TheCacophonyProject/spool-pcb/README.md

# Spool PCB

## Other bits to order

### DigiKey

- 2 x Crimped leads: [455-4118-ND](https://www.digikey.com/en/products/detail/jst-sales-america-inc/ASXASXA22K254/9951627) Can chop in half and use 2 of the ends for the motor and 2 for the magnet
- 1 x 8 Pin cable assembly [455-3842-ND](https://www.digikey.com/en/products/detail/jst-sales-america-inc/A08XAF08XAF22K203B/9922118) for connecting main and plug board.
- 3 x Protection Diodes [SS54-HF](https://www.digikey.com/en/products/detail/comchip-technology/SS54-HF/11584321) to be hand soldered onto the plug board.

### LCSC

- 2 x Photo interrupter [DY-ITR8402](https://www.lcsc.com/product-detail/C390039.html)
- 1 x 2 Pin JST XA housing [XAP-02V-1](https://www.lcsc.com/product-detail/C157892.html)
- 1 x 3 Pin JST XA housing [XAP-03V-1](https://www.lcsc.com/product-detail/C157891.html)
- 2 x 8 Pin JST XA Plug [S08B-XASK-1(LF)(SN)](https://www.lcsc.com/product-detail/C495695.html)
- 1 x Magnet rotary position sensor? Not too sure if this will end up being used or not. [AS5600-ASOT](https://www.lcsc.com/product-detail/C499458.html)

### JNICON

- 1 x 6 Pin Auxiliary plug (TODO: Add part number)
- 1 x 4 Pin Power plug (TODO: Add part number)

## Construction

TODO: Write construction/programming instructions.
