TheCacophonyProject/spool-pcb/spool-plugs/solder-helper.FCStd

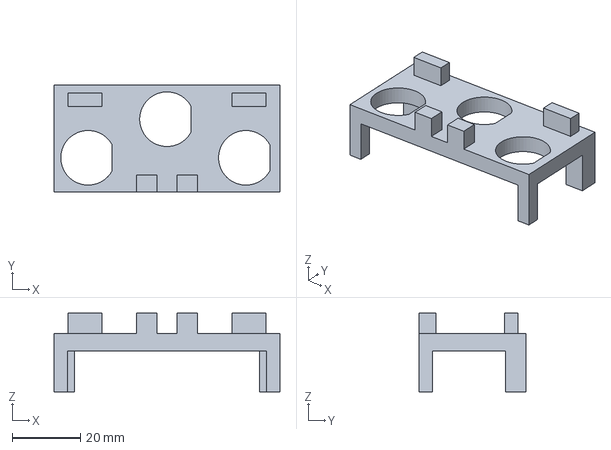
[picture p1: CAD file, 2026-06-03]
spool-plugs/solder-helper.FCStd
66.2 x 31.3 x 23.0 mm
