TheCacophonyProject/spool-pcb/(list of files, cad)

Other CAD files:
cage-hub/drawings/cage-hub.FCStd
spool-plugs/drawings/spool-plugs-drawings.FCStd
spool/drawings/spool.FCStd
spool/drawings/cutout.FCStd
