TheCacophonyProject/spool-pcb/spool/spool.kicad_pcb

## KiCad design spool/spool.kicad_pcb (2026-11-05)

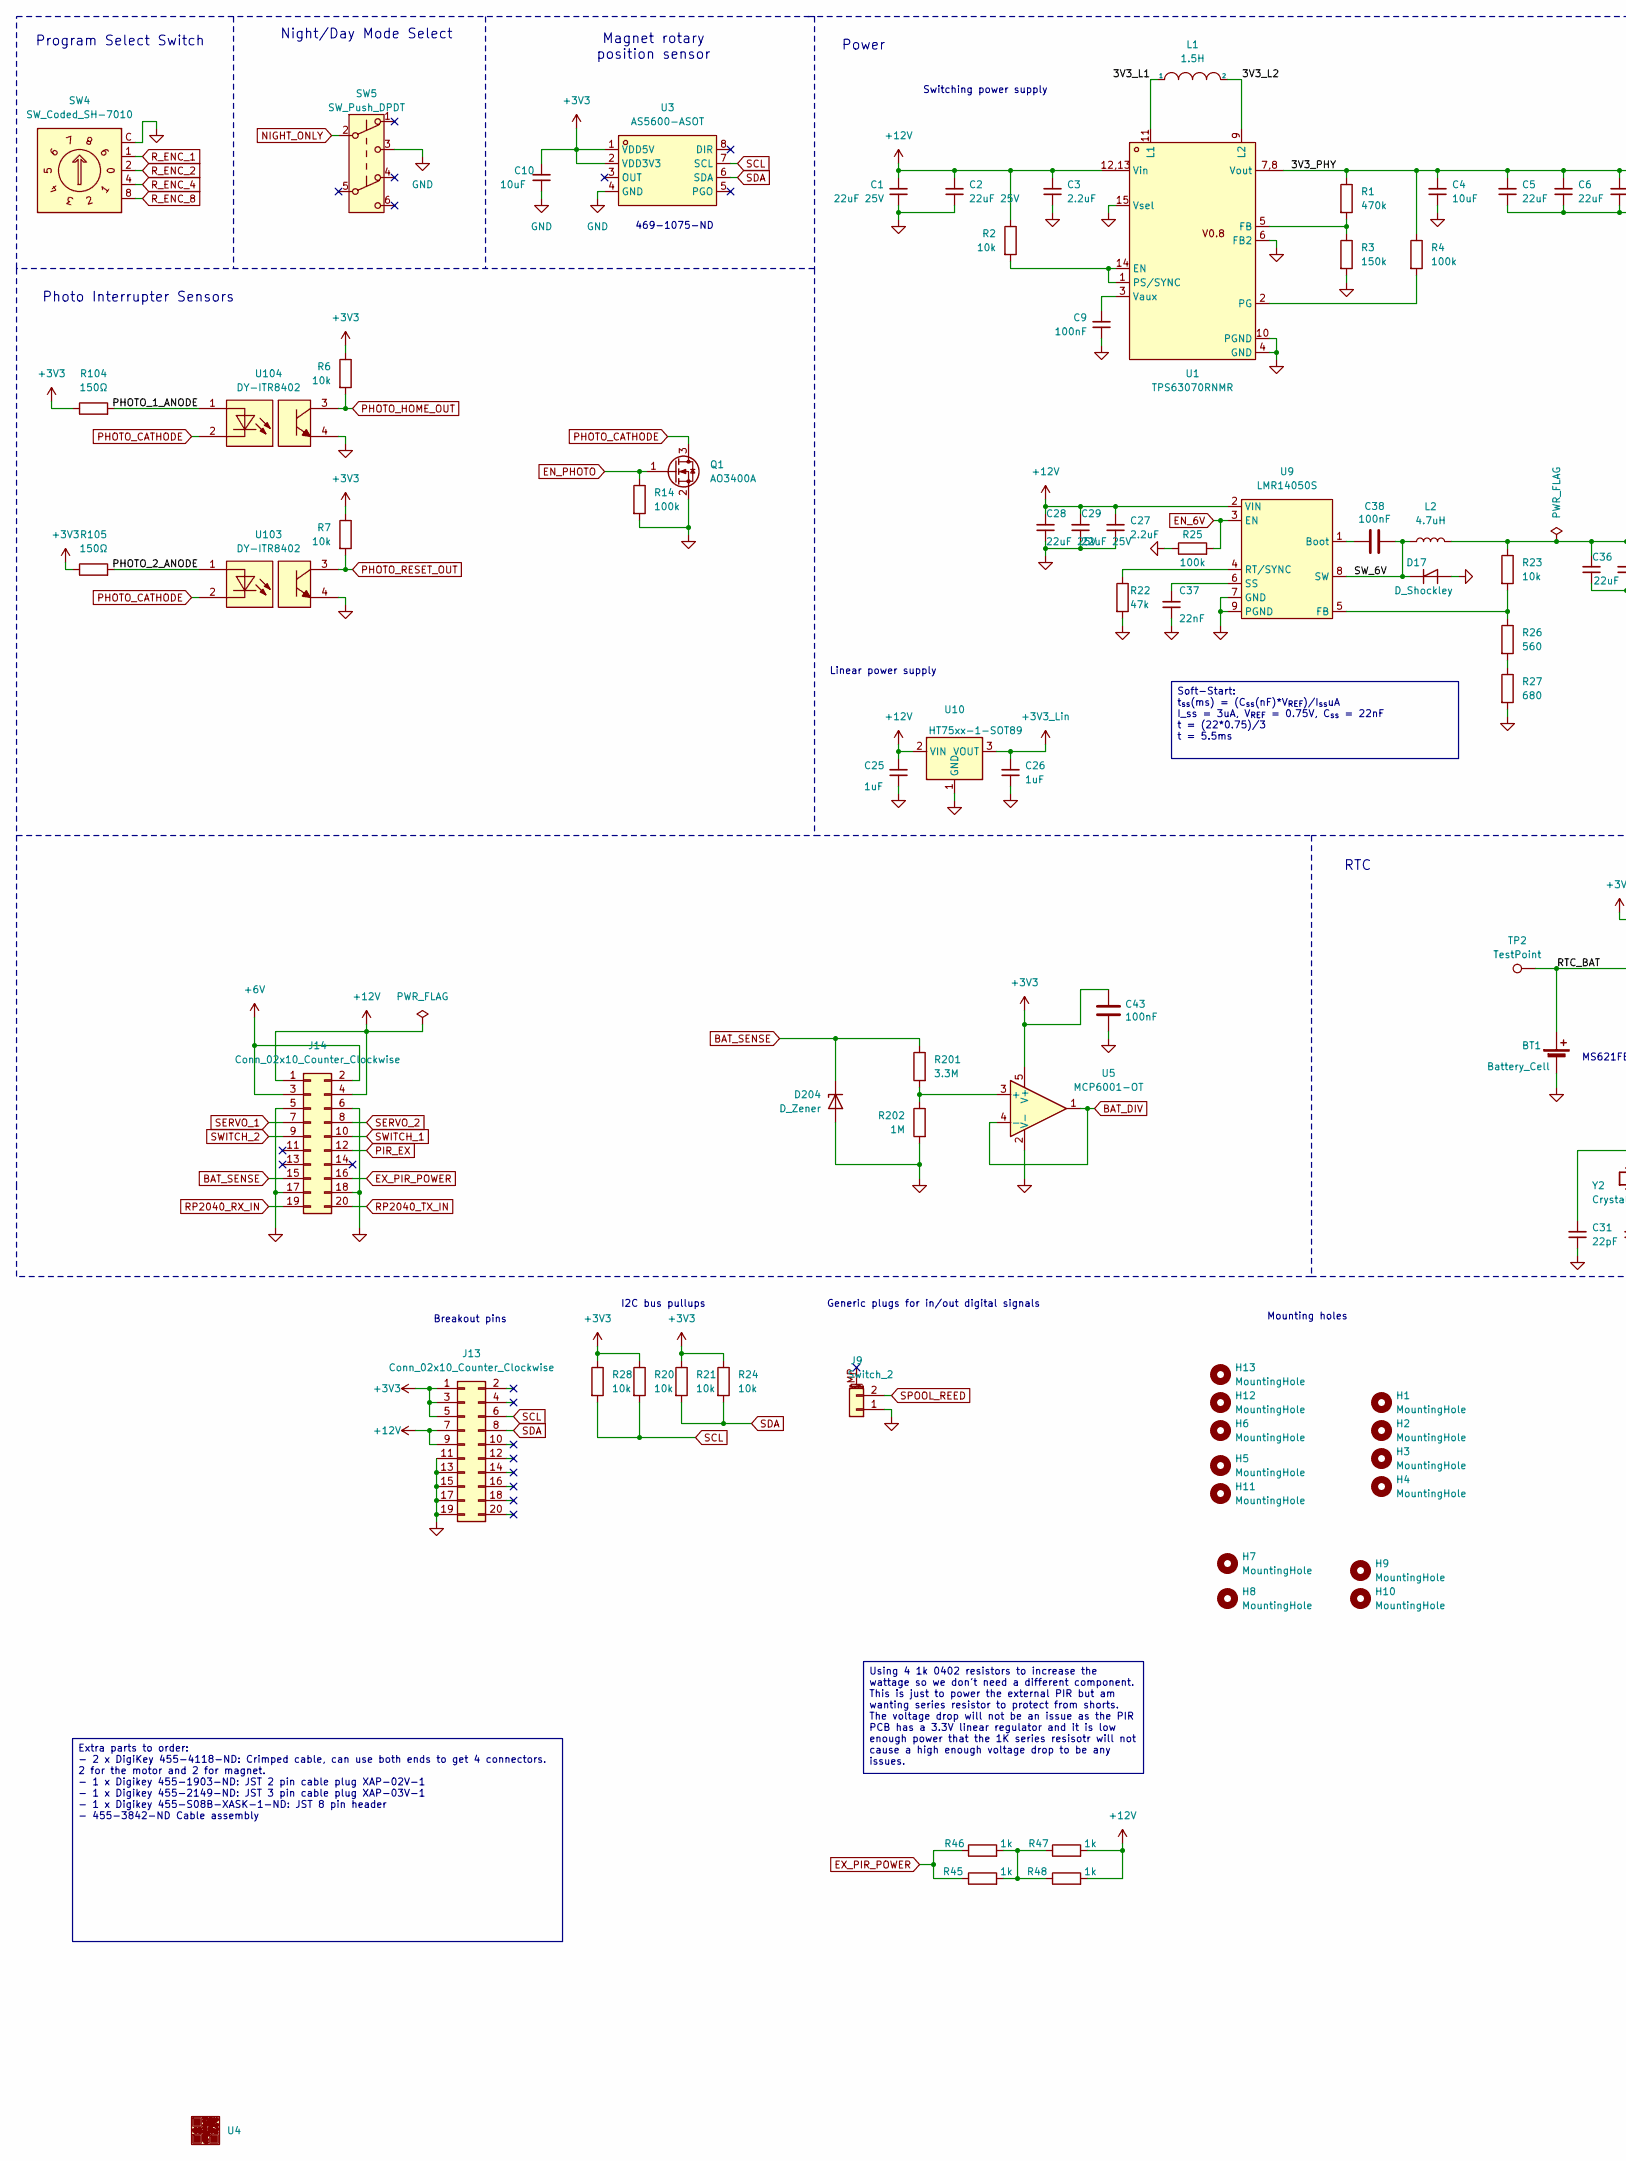
[picture p2: schematic spool.kicad_sch, part in row 1, column 1]

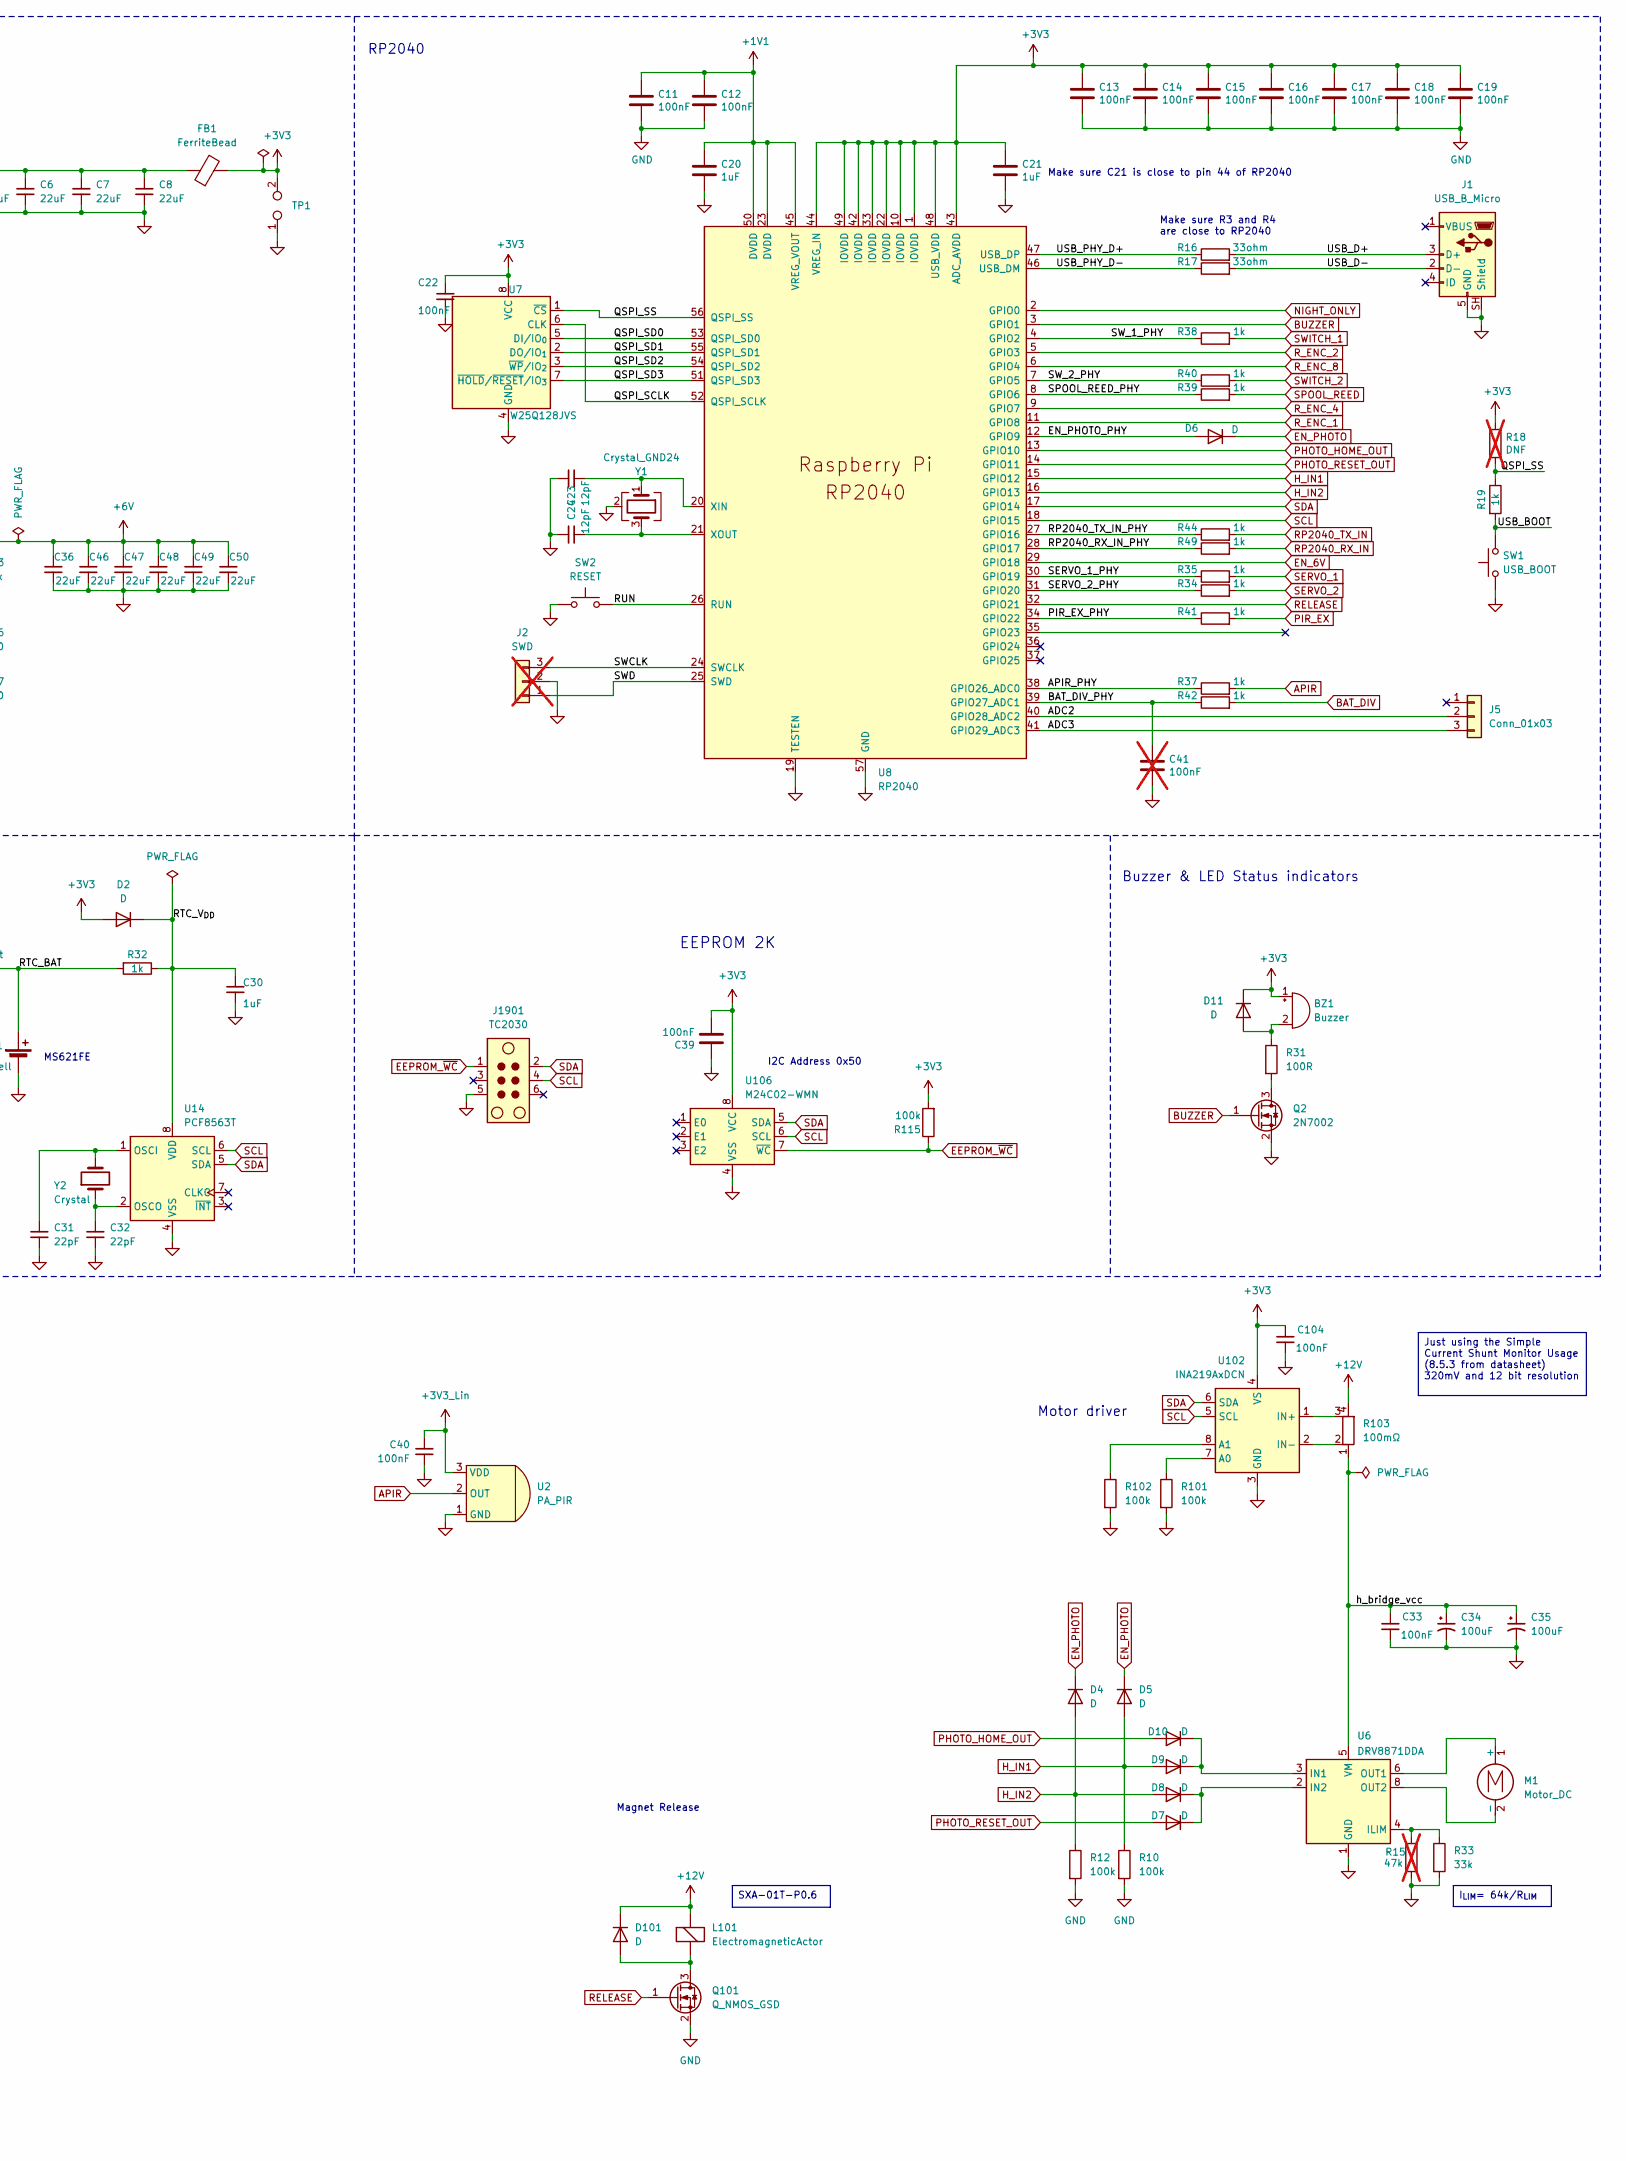
[picture p3: schematic spool.kicad_sch, part in row 1, column 2]

Parts:
BT1: Battery_Cell; CAP-SMD_FL11E; LCSC Part C80909
BZ1: Buzzer; BUZ-TH_BD9.0-P4.00-D0.6-FD; LCSC Part C96256
C1, C2, C28, C29: 22uF 25V; C_0805_2012Metric; LCSC Part C45783
C3, C27: 2.2uF; C_0402_1005Metric; LCSC Part C159814
C4, C10: 10uF; C_0402_1005Metric; LCSC Part C15525
C5, C6, C7, C8, C36, C46, C47, C48, C49, C50: 22uF; C_0603_1608Metric; LCSC Part C86295
C9, C11, C12, C13, C14, C15, C16, C17, C18, C19, C22, C33, C38, C39, C40, C43, C104: 100nF; C_0402_1005Metric; LCSC Part C307331
C20, C21, C25, C26, C30: 1uF; C_0402_1005Metric; LCSC Part C52923
C23, C24: 12pF; C_0402_1005Metric; LCSC Part C1547
C31, C32: 22pF; C_0402_1005Metric; LCSC Part C1555
C34, C35: 100uF; CP_Elec_6.3x7.7; LCSC Part C3338
C37: 22nF; C_0402_1005Metric; LCSC Part C1532
C41: 100nF; C_0402_1005Metric; LCSC Part C307331; not fitted
D2, D4, D5, D6, D7, D8, D9, D10, D11, D101: D; D_SOD-323; LCSC Part C2128
D17: D_Shockley; D_SMA; LCSC Part C22452
D204: D_Zener; D_SOD-123; LCSC Part C19077413
FB1: FerriteBead; L_0805_2012Metric; LCSC Part C76818
H1, H2, H3, H4, H9, H10: MountingHole; MountingHole_3.5mm_M3
H5, H6, H7, H8, H11, H12, H13: MountingHole; 3.0mm_key_hole
J1: USB_B_Micro; MICRO-USB-TH_MICRO-USB-A14; LCSC Part C145795
J2: SWD; PinHeader_1x03_P1.00mm_Vertical; not fitted
J5: Conn_01x03; PinHeader_1x03_P2.54mm_Vertical
J9: Switch_2; JST_SH_BM02B-SRSS-TB_1x02-1MP_P1.00mm_Vertical; LCSC Part C160388
J13: Conn_02x10_Counter_Clockwise; test-headers
J14: Conn_02x10_Counter_Clockwise; PinSocket_2x10_P2.54mm_Vertical; LCSC Part C92266
J1901: TC2030; Tag-Connect_TC2030-IDC-NL_2x03_P1.27mm_Vertical
L1: 1.5H; L_1008_2520Metric; LCSC Part C2042459
L2: 4.7uH; IND-SMD_L7.0-W6.6; LCSC Part C408447
L101: ElectromagneticActor; JST_XA_B03B_2_Pin; LCSC Part C264992
M1: Motor_DC; JST_XA_B02B-XASK-1-A_1x02_P2.50mm_Vertical; LCSC Part C265077
Q1: AO3400A; SOT-23; LCSC Part C20917
Q2: 2N7002; SOT-23; LCSC Part C8545
Q101: Q_NMOS_GSD; SOT-23; LCSC Part C332302
R1: 470k; R_0402_1005Metric; LCSC Part C319591
R2, R6, R7, R20, R21, R23, R24, R28: 10k; R_0402_1005Metric; LCSC Part C25744
R3: 150k; R_0402_1005Metric; LCSC Part C723770
R4, R10, R12, R14, R25, R101, R102, R115: 100k; R_0402_1005Metric; LCSC Part C25741
R15: 47k; R_Axial_DIN0204_L3.6mm_D1.6mm_P7.62mm_Horizontal; not fitted
R16, R17: 33ohm; R_0402_1005Metric; LCSC Part C25105
R18: DNF; R_0402_1005Metric; not fitted
R19, R32, R34, R35, R37, R38, R39, R40, R41, R42, R44, R45, R46, R47, R48, R49: 1k; R_0402_1005Metric; LCSC Part C11702
R22: 47k; R_0402_1005Metric; LCSC Part C25792
R26: 560; R_0603_1608Metric; LCSC Part C23204
R27: 680; R_0603_1608Metric; LCSC Part C23228
R31: 100R; R_0402_1005Metric; LCSC Part C25076
R33: 33k; R_0805_2012Metric_Pad1.20x1.40mm_HandSolder; LCSC Part C17633
R103: 100mΩ; R_1206_Shunt; LCSC Part C25334
R104, R105: 150Ω; R_0603_1608Metric; LCSC Part C22808
R201: 3.3M; R_0603_1608Metric; LCSC Part C26096
R202: 1M; R_0603_1608Metric; LCSC Part C22935
SW1: USB_BOOT; SW_SPST_SKQG_WithStem; LCSC Part C318884
SW2: RESET; SW_SPST_SKQG_WithStem; LCSC Part C318884
SW4: SW_Coded_SH-7010; SW-TH_6P-L10.0-W10.0-P2.54-LS7.6_TSR-10; LCSC Part C440495
SW5: SW_Push_DPDT; SW-TH_K3-2235D-F1; LCSC Part C189615
TP1: TestPoint_2Pole; test-point-2p
TP2: TestPoint; TestPoint_Loop_D1.80mm_Drill1.0mm_Beaded
U1: TPS63070RNMR; TPS63070; LCSC Part C109322
U2: PA_PIR
U3: AS5600-ASOT; SOIC-8_3.9x4.9mm_P1.27mm; LCSC Part C499458
U4: JLCPCB_QR_8mm
U5: MCP6001-OT; SOT-23-5; LCSC Part C29429
U6: DRV8871DDA; Texas_HTSOP-8-1EP_3.9x4.9mm_P1.27mm_EP2.95x4.9mm_Mask2.4x3.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; LCSC Part C75864
U7: W25Q128JVS; SOIC-8_5.3x5.3mm_P1.27mm; LCSC Part C97521
U8: RP2040; RP2040-QFN-56; LCSC Part C2040
U9: LMR14050S; TI_SO-PowerPAD-8; LCSC Part C155484
U10: HT75xx-1-SOT89; SOT-89-3; LCSC Part C14289
U14: PCF8563T; SOIC-8_3.9x4.9mm_P1.27mm; LCSC Part C7440
U102: INA219AxDCN; SOT-23-8; LCSC Part C87469
U103, U104: DY-ITR8402; OPTO-TH_DY-ITR8402; LCSC Part C390039
U106: M24C02-WMN; SOIC-8_3.9x4.9mm_P1.27mm; LCSC Part C7562
Y1: Crystal_GND24; Crystal_SMD_3225-4Pin_3.2x2.5mm; LCSC Part C9002
Y2: Crystal; Crystal_SMD_3215-2Pin_3.2x1.5mm; LCSC Part C32346

Connections:
+1V1: C11.1, C12.1, C20.1, U8.23 (DVDD), U8.45 (VREG_VOUT), U8.50 (DVDD)
+3V3: BZ1.1 (+), C10.1, C13.1, C14.1, C15.1, C16.1, C17.1, C18.1, C19.1, C21.1, C22.1, C39.2, C43.1, C104.1, D2.2 (A), D11.1 (K), FB1.2, J13.1, J13.3, J13.5, R6.1, R7.1, R18.1, R20.1, R21.1, R24.1, R28.1, R104.1, R105.1, R115.2, TP1.2, U3.1 (VDD5V), U3.2 (VDD3V3), U5.5 (V+), U7.8 (VCC), U8.1 (IOVDD), U8.10 (IOVDD), U8.22 (IOVDD), U8.33 (IOVDD), U8.42 (IOVDD), U8.43 (ADC_AVDD), U8.44 (VREG_IN), U8.48 (USB_VDD), U8.49 (IOVDD), U102.4 (VS), U106.8 (VCC)
+3V3_Lin: C26.1, C40.1, U2.3 (VDD), U10.3 (VOUT)
+6V: C36.1, C46.1, C47.1, C48.1, C49.1, C50.1, J14.2, J14.3, L2.2, R23.1
+12V: C1.1, C2.1, C3.1, C25.1, C27.1, C28.1, C29.1, D101.1 (K), J13.7, J13.9, J14.1, J14.4, L101.1 (-), R2.1, R47.2, R48.2, R103.4, U1.12,13 (Vin), U9.2 (VIN), U10.2 (VIN)
/3V3_L1: L1.1, U1.11 (L1)
/3V3_L2: L1.2, U1.9 (L2)
/3V3_PHY: C4.1, C5.1, C6.1, C7.1, C8.1, FB1.1, R1.1, R4.1, U1.7,8 (Vout)
/ADC2: J5.2, U8.40 (GPIO28_ADC2)
/ADC3: J5.3, U8.41 (GPIO29_ADC3)
/APIR_PHY: R37.1, U8.38 (GPIO26_ADC0)
/BAT_DIV_PHY: C41.1, R42.1, U8.39 (GPIO27_ADC1)
/EN_PHOTO_PHY: D6.2 (A), U8.12 (GPIO9)
/PHOTO_1_ANODE: R104.2, U104.1
/PHOTO_2_ANODE: R105.2, U103.1
/PIR_EX_PHY: R41.1, U8.34 (GPIO22)
/QSPI_SCLK: U7.6 (CLK), U8.52 (QSPI_SCLK)
/QSPI_SD0: U7.5 (DI/IO_{0}), U8.53 (QSPI_SD0)
/QSPI_SD1: U7.2 (DO/IO_{1}), U8.55 (QSPI_SD1)
/QSPI_SD2: U7.3 (~WP/IO_{2}), U8.54 (QSPI_SD2)
/QSPI_SD3: U7.7 (~HOLD/~RESET/IO_{3}), U8.51 (QSPI_SD3)
/QSPI_SS: R18.2, R19.1, U7.1 (~CS), U8.56 (QSPI_SS)
/RP2040_RX_IN_PHY: R49.1, U8.28 (GPIO17)
/RP2040_TX_IN_PHY: R44.1, U8.27 (GPIO16)
/RTC_BAT: BT1.1 (+), R32.2, TP2.1 (1_1)
/RTC_V_{DD}: C30.1, D2.1 (K), R32.1, U14.8 (VDD)
/RUN: SW2.2, U8.26 (RUN)
/SERVO_1_PHY: R35.1, U8.30 (GPIO19)
/SERVO_2_PHY: R34.1, U8.31 (GPIO20)
/SPOOL_REED_PHY: R39.1, U8.8 (GPIO6)
/SWCLK: J2.3, U8.24 (SWCLK)
/SWD: J2.1, U8.25 (SWD)
/SW_1_PHY: R38.1, U8.4 (GPIO2)
/SW_2_PHY: R40.1, U8.7 (GPIO5)
/SW_6V: C38.1, D17.1 (K), L2.1, U9.8 (SW)
/USB_BOOT: R19.2, SW1.2
/USB_D+: J1.3 (D+), R16.2
/USB_D-: J1.2 (D-), R17.2
/USB_PHY_D+: R16.1, U8.47 (USB_DP)
/USB_PHY_D-: R17.1, U8.46 (USB_DM)
/h_bridge_vcc: C33.1, C34.1, C35.1, R103.1, U6.5 (VM)
APIR: R37.2, U2.2 (OUT)
BAT_DIV: R42.2, U5.1, U5.4 (-)
BAT_SENSE: D204.1 (K), J14.15, R201.1
BUZZER: Q2.1 (G), U8.3 (GPIO1)
EEPROM_~WC: J1901.1, R115.1, U106.7 (~WC)
EN_6V: R25.2, U8.29 (GPIO18), U9.3 (EN)
EN_PHOTO: D4.1 (K), D5.1 (K), D6.1 (K), Q1.1 (G), R14.1
EX_PIR_POWER: J14.16, R45.1, R46.1
GND: BT1.2 (-), C1.2, C2.2, C3.2, C4.2, C5.2, C6.2, C7.2, C8.2, C9.2, C10.2, C11.2, C12.2, C13.2, C14.2, C15.2, C16.2, C17.2, C18.2, C19.2, C20.2, C21.2, C22.2, C23.1, C24.1, C25.2, C26.2, C27.2, C28.2, C29.2, C30.2, C31.2, C32.2, C33.2, C34.2, C35.2, C36.2, C37.2, C39.1, C40.2, C41.2, C43.2, C46.2, C47.2, C48.2, C49.2, C50.2, C104.2, D17.2 (A), D204.2 (A), J1.5 (GND), J1.SH (Shield), J2.2, J9.1, J13.11, J13.13, J13.15, J13.17, J13.19, J14.5, J14.6, J14.17, J14.18, J1901.5, Q1.2 (S), Q2.2 (S), Q101.2 (S), R3.2, R10.2, R12.2, R14.2, R15.2, R22.2, R25.1, R27.2, R33.2, R101.2, R102.2, R202.2, SW1.1, SW2.1, SW4.C, SW5.3 (C), TP1.1, U1.4 (GND), U1.6 (FB2), U1.10 (PGND), U1.15 (Vsel), U2.1 (GND), U3.4 (GND), U5.2 (V-), U6.1 (GND), U6.7 (GND), U6.9 (GND), U7.4 (GND), U8.19 (TESTEN), U8.57 (GND), U9.7 (GND), U9.9 (PGND), U10.1 (GND), U14.4 (VSS), U102.3 (GND), U103.4, U104.4, U106.4 (VSS), Y1.2 (G), Y1.4 (G)
H_IN1: D5.2 (A), D9.2 (A), R10.1, U8.15 (GPIO12)
H_IN2: D4.2 (A), D8.2 (A), R12.1, U8.16 (GPIO13)
NIGHT_ONLY: SW5.2 (B), U8.2 (GPIO0)
unnamed: BZ1.2 (-), D11.2 (A), R31.1
unnamed: D7.1 (K), D8.1 (K), U6.2 (IN2)
unnamed: D9.1 (K), D10.1 (K), U6.3 (IN1)
unnamed: D101.2 (A), L101.2 (+), Q101.3 (D)
unnamed: M1.1 (+), U6.6 (OUT1)
unnamed: M1.2 (-), U6.8 (OUT2)
unnamed: Q2.3 (D), R31.2
unnamed: R26.2, R27.1
unnamed: R45.2, R46.2, R47.1, R48.1
unnamed: R2.2, U1.1 (PS/SYNC), U1.14 (EN)
unnamed: R1.2, R3.1, U1.5 (FB)
unnamed: R4.2, U1.2 (PG)
unnamed: C9.1, U1.3 (Vaux)
unnamed: R201.2, R202.1, U5.3 (+)
unnamed: R15.1, R33.1, U6.4 (ILIM)
unnamed: C23.2, U8.20 (XIN), Y1.1
unnamed: C24.2, U8.21 (XOUT), Y1.3
unnamed: C38.2, U9.1 (Boot)
unnamed: R23.2, R26.1, U9.5 (FB)
unnamed: R22.1, U9.4 (RT/SYNC)
unnamed: C37.1, U9.6 (SS)
unnamed: C31.1, U14.1 (OSCI), Y2.2
unnamed: C32.1, U14.2 (OSCO), Y2.1
unnamed: R101.1, U102.7 (A0)
unnamed: R102.1, U102.8 (A1)
unnamed: R103.3, U102.1 (IN+)
unnamed: R103.2, U102.2 (IN-)
PHOTO_CATHODE: Q1.3 (D), U103.2, U104.2
PHOTO_HOME_OUT: D10.2 (A), R6.2, U8.13 (GPIO10), U104.3
PHOTO_RESET_OUT: D7.2 (A), R7.2, U8.14 (GPIO11), U103.3
PIR_EX: J14.12, R41.2
RELEASE: Q101.1 (G), U8.32 (GPIO21)
RP2040_RX_IN: J14.19, R49.2
RP2040_TX_IN: J14.20, R44.2
R_ENC_1: SW4.1, U8.11 (GPIO8)
R_ENC_2: SW4.2, U8.5 (GPIO3)
R_ENC_4: SW4.4, U8.9 (GPIO7)
R_ENC_8: SW4.8, U8.6 (GPIO4)
SCL: J13.6, J1901.4, R20.2, R28.2, U3.7 (SCL), U8.18 (GPIO15), U14.6 (SCL), U102.5 (SCL), U106.6 (SCL)
SDA: J13.8, J1901.2, R21.2, R24.2, U3.6 (SDA), U8.17 (GPIO14), U14.5 (SDA), U102.6 (SDA), U106.5 (SDA)
SERVO_1: J14.7, R35.2
SERVO_2: J14.8, R34.2
SPOOL_REED: J9.2, R39.2
SWITCH_1: J14.10, R38.2
SWITCH_2: J14.9, R40.2

Notes on the sheet:
Magnet Release
Breakout pins
I2C bus pullups
Make sure R3 and R4 are close to RP2040
RTC
Program Select Switch
Photo Interrupter Sensors
Buzzer & LED Status indicators
Night/Day Mode Select
Switching power supply
469-1075-ND
Magnet rotary position sensor
Make sure C21 is close to pin 44 of RP2040
Power
Linear power supply
MS621FE
Generic plugs for in/out digital signals
Mounting holes
I2C Address 0x50
Motor driver
EEPROM 2K
RP2040
Using 4 1k 0402 resistors to increase the wattage so we don't need a different component. This is just to power the external PIR but am wanting series resistor to protect from shorts. The voltage drop will not be an issue as the PIR PCB has a 3.3V linear regulator and it is low enough power that th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
Extra parts to order: - 2 x DigiKey 455-4118-ND: Crimped cable, can use both ends to get 4 connectors. 2 for the motor and 2 for magnet. - 1 x Digikey 455-1903-ND: JST 2 pin cable plug XAP-02V-1 - 1 x Digikey 455-2149-ND: JST 3 pin cable plug XAP-03V-1 - 1 x Digikey 455-S08B-XASK-1-ND: JST 8 pin he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
Soft-Start: t_{ss}(ms) = (C_{ss}(nF)*V_{REF})/I_{ss}uA I_ss = 3uA, V_{REF} = 0.75V, C_{ss} = 22nF t = (22*0.75)/3 t = 5.5ms
Just using the Simple Current Shunt Monitor Usage (8.5.3 from datasheet) 320mV and 12 bit resolution
I_{LIM}= 64k/R_{LIM}
SXA-01T-P0.6

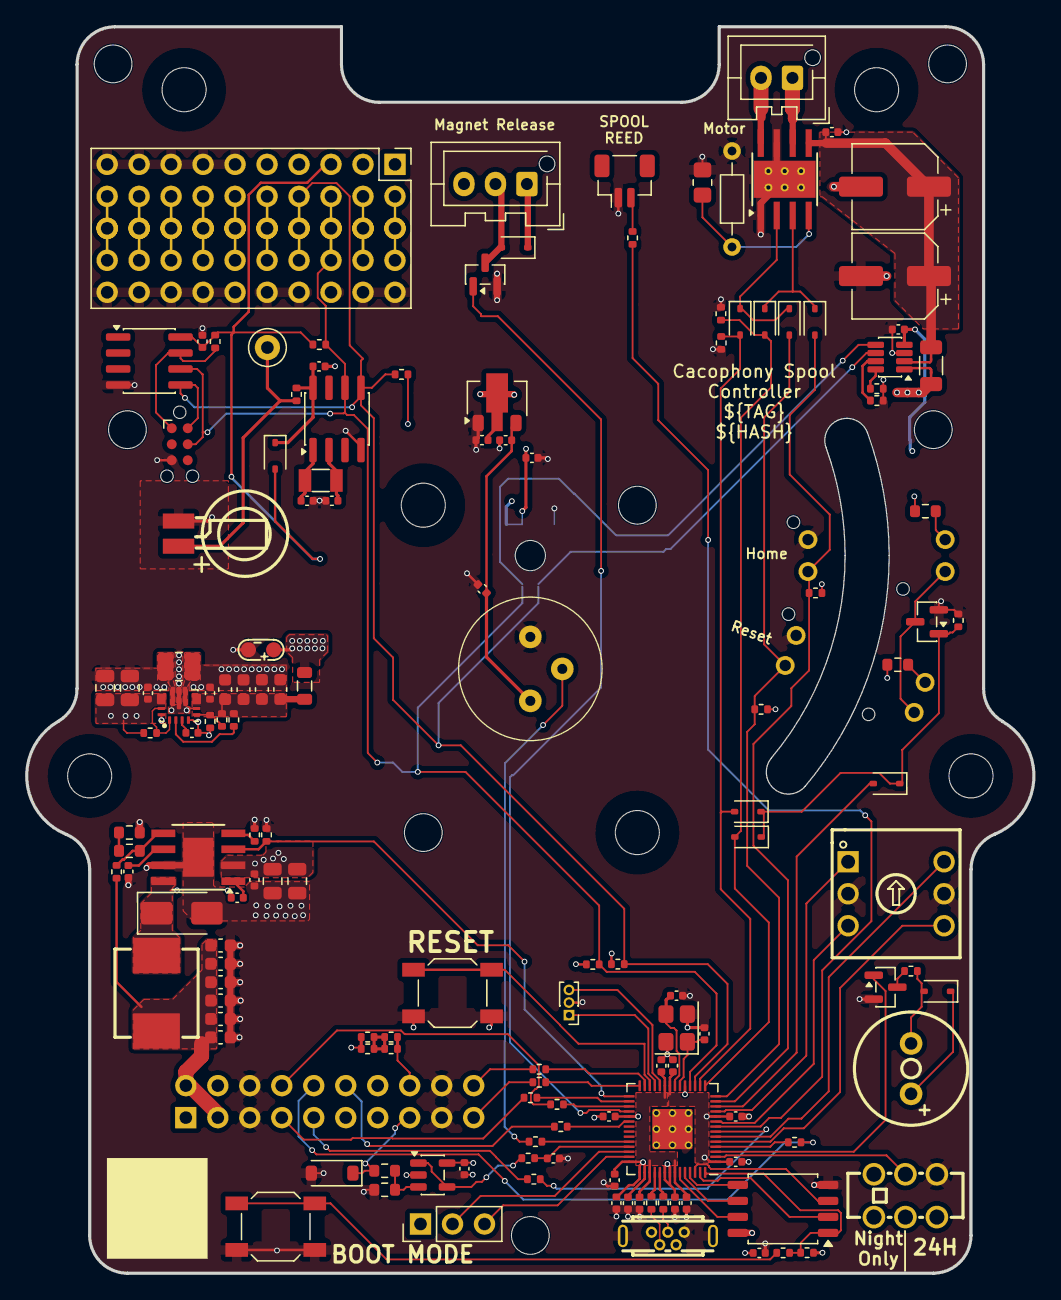
[picture p4: board spool.kicad_pcb from above]

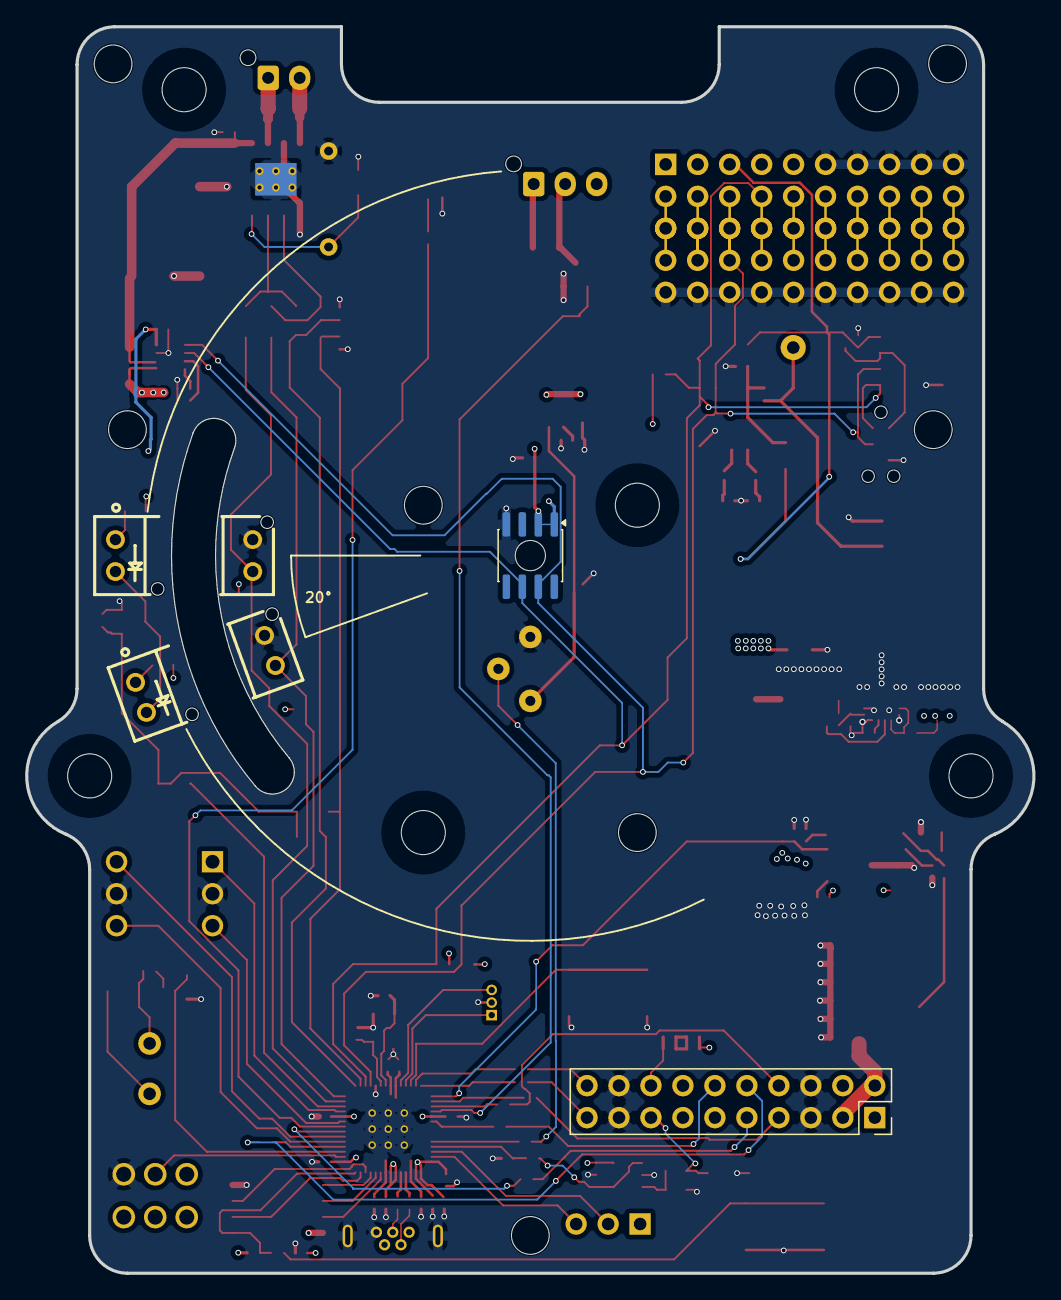
[picture p5: board spool.kicad_pcb from below]

Board: 4 copper layers, 80.0 x 99.0 mm, 161 parts (4 on the bottom side), 98 nets.
