TheCacophonyProject/spool-pcb/spool-plugs/spool-plugs.kicad_pcb

## KiCad design spool-plugs/spool-plugs.kicad_pcb (2026-11-03)

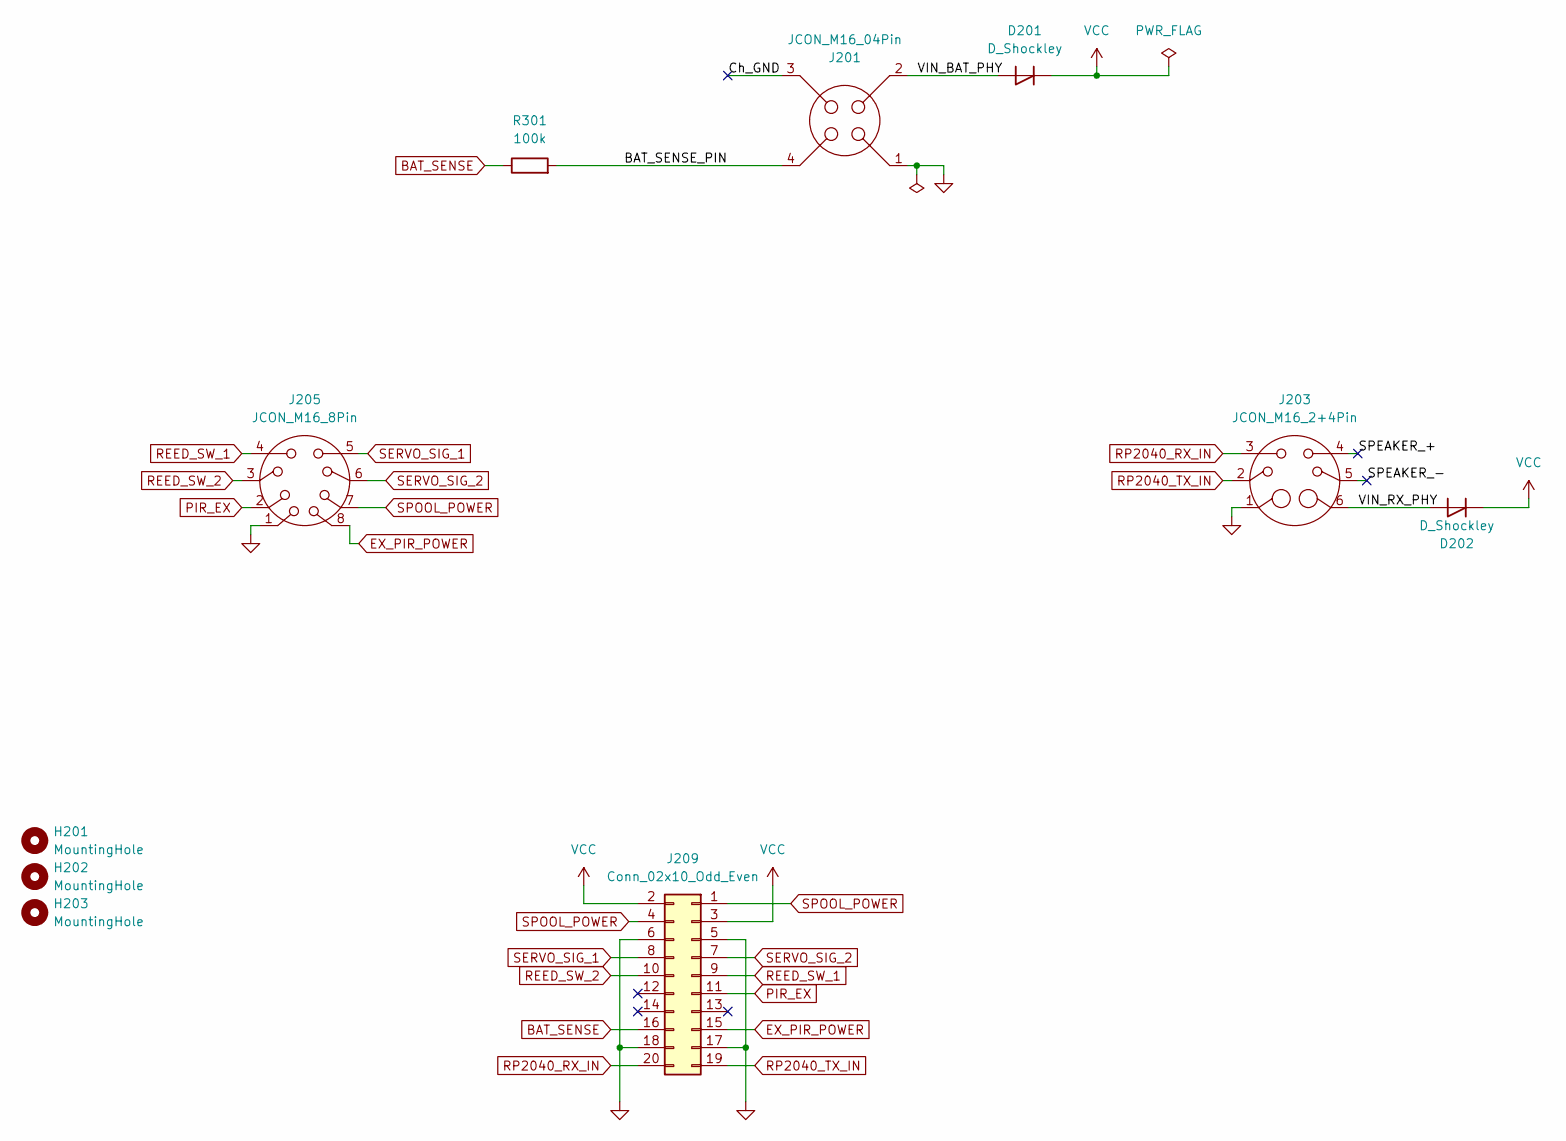
[picture p6: schematic spool-plugs.kicad_sch]

Parts:
D201, D202: D_Shockley; D_SMA_Handsoldering; Digikey 641-SS54-HFCT-ND
H201, H202, H203: MountingHole; 3.0mm_key_hole
J201: JCON_M16_04Pin; jcon-4pin_m16
J203: JCON_M16_2+4Pin; jcon-2+4pin-m16
J205: JCON_M16_8Pin; jcon-8pin-m16
J209: Conn_02x10_Odd_Even; spool_pcb-pcb_connector; LCSC Part C5383093
R301: 100k; R_0805_2012Metric_Pad1.20x1.40mm_HandSolder; LCSC Part C149504

Connections:
/BAT_SENSE_PIN: J201.4, R301.2
/Ch_GND: J201.3
/SPEAKER_+: J203.4
/SPEAKER_-: J203.5
/VIN_BAT_PHY: D201.2 (A), J201.2
/VIN_RX_PHY: D202.2 (A), J203.6
BAT_SENSE: J209.16, R301.1
EX_PIR_POWER: J205.8, J209.15
GND: J201.1, J203.1, J205.1, J209.5, J209.6, J209.17, J209.18
PIR_EX: J205.2, J209.11
REED_SW_1: J205.4, J209.9
REED_SW_2: J205.3, J209.10
RP2040_RX_IN: J203.3, J209.20
RP2040_TX_IN: J203.2, J209.19
SERVO_SIG_1: J205.5, J209.8
SERVO_SIG_2: J205.6, J209.7
SPOOL_POWER: J205.7, J209.1, J209.4
VCC: D201.1 (K), D202.1 (K), J209.2, J209.3

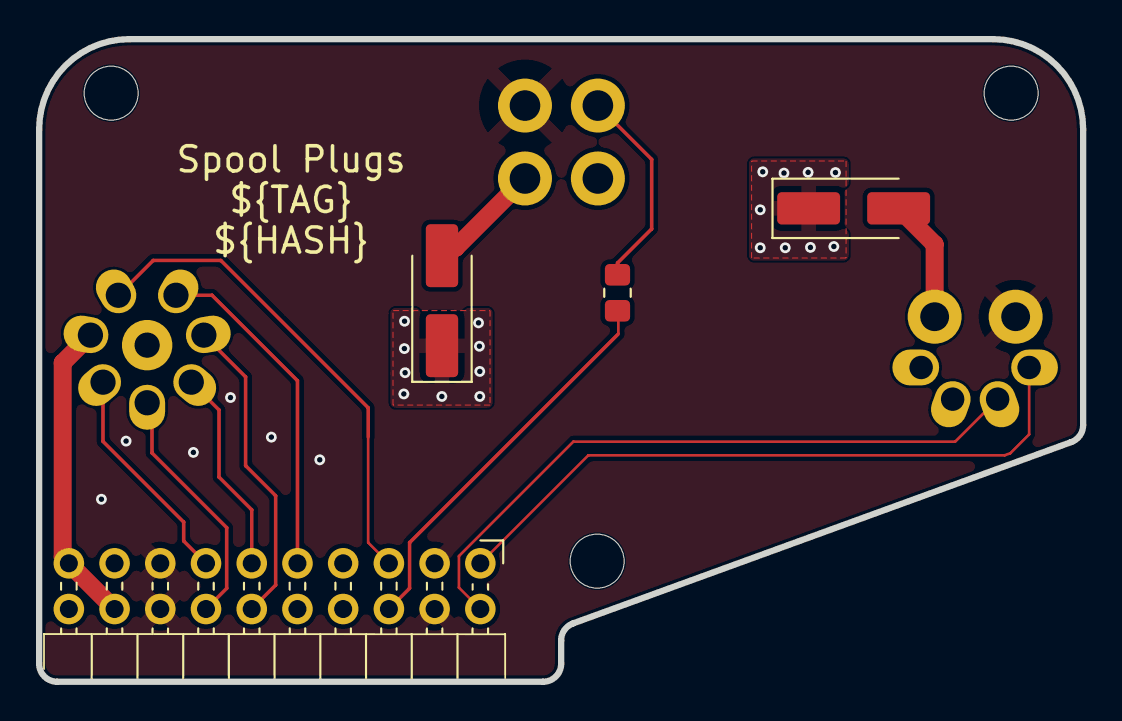
[picture p7: board spool-plugs.kicad_pcb from above]

Board: 4 copper layers, 58.0 x 35.7 mm, 10 parts (0 on the bottom side), 15 nets.
