TheCacophonyProject/spool-pcb/pir/pir.kicad_pcb

## KiCad design pir/pir.kicad_pcb (2026-10-27)

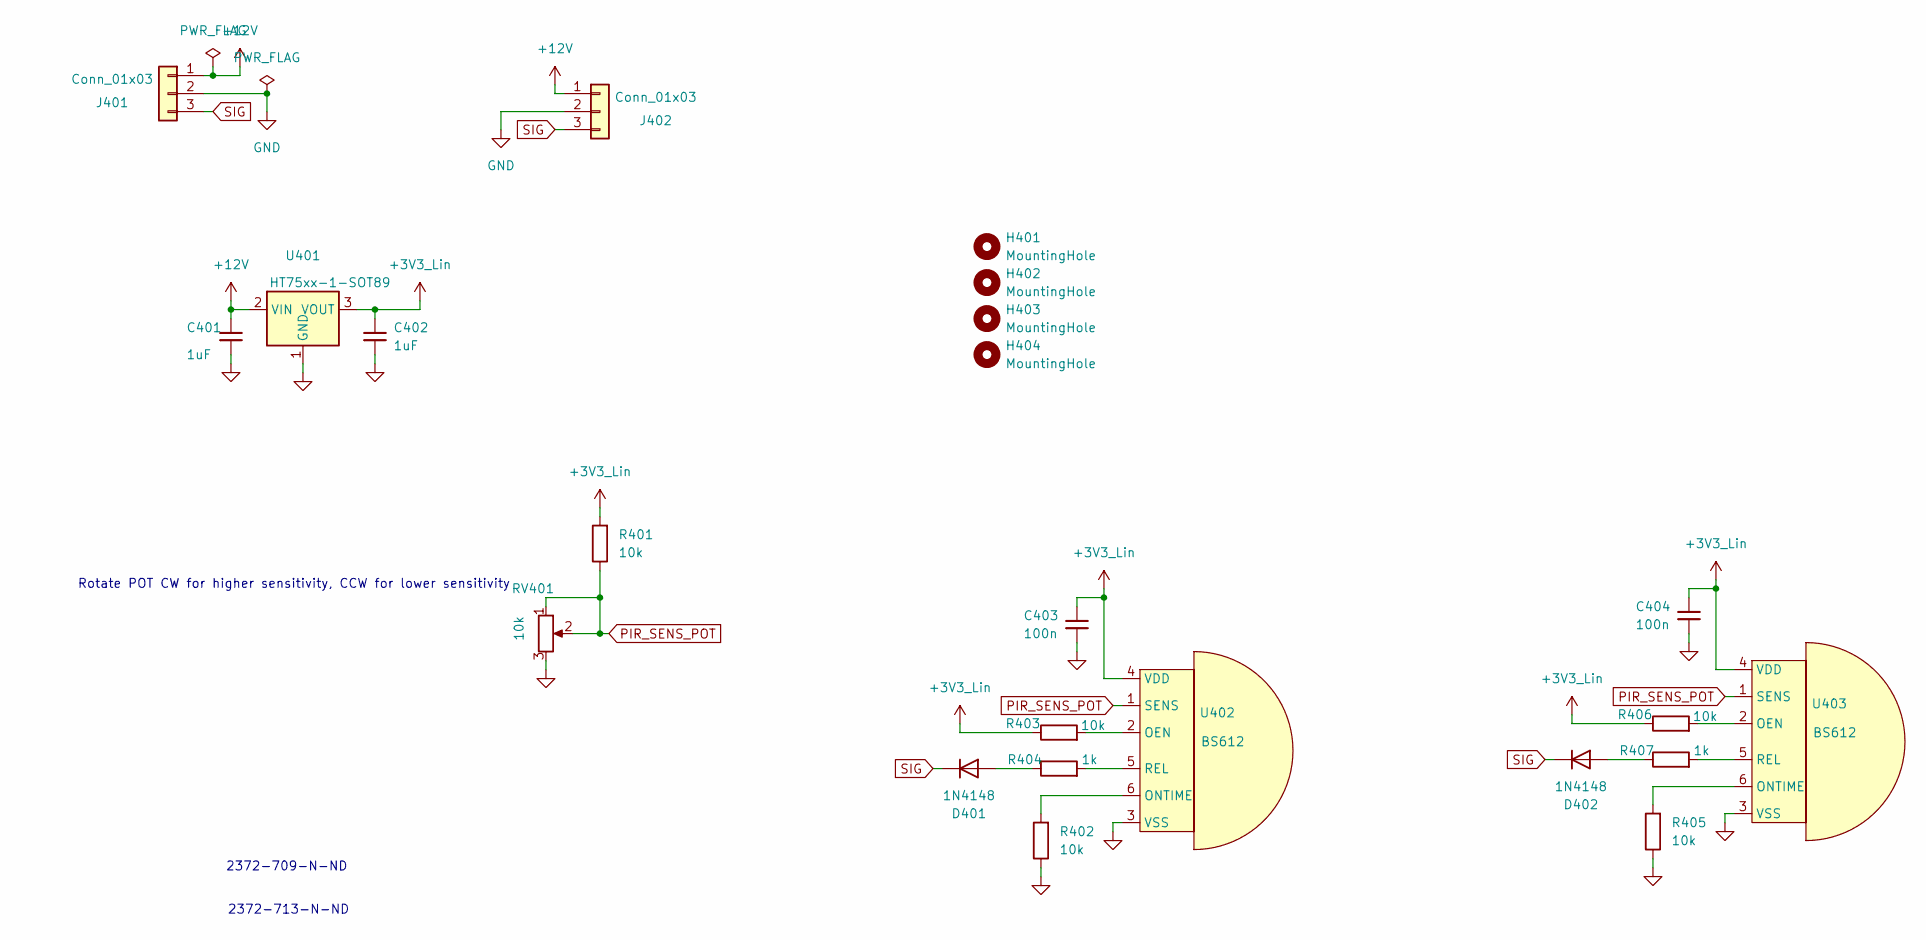
[picture p8: schematic pir.kicad_sch]

Parts:
C401, C402: 1uF; C_0603_1608Metric; LCSC Part C15849
C403, C404: 100n; C_0402_1005Metric; LCSC Part C307331
D401, D402: 1N4148; D_SOD-123; LCSC Part C81598
H401, H402, H403, H404: MountingHole; MountingHole_3.2mm_M3
J401, J402: Conn_01x03; JST_XA_S03B-XASK-1_1x03_P2.50mm_Horizontal; LCSC Part C491707
R401, R402, R403, R405, R406: 10k; R_0603_1608Metric; LCSC Part C25804
R404, R407: 1k; R_0603_1608Metric; LCSC Part C21190
RV401: 10k; RES-ADJ-TH_3362P; LCSC Part C58159
U401: HT75xx-1-SOT89; SOT-89-3; LCSC Part C14289
U402, U403: BS612; SENSORM-TH_BS612; LCSC Part C389589

Connections:
+3V3_Lin: C402.1, C403.1, C404.1, R401.2, R403.1, R406.1, U401.3 (VOUT), U402.4 (VDD), U403.4 (VDD)
+12V: C401.1, J401.1, J402.1, U401.2 (VIN)
GND: C401.2, C402.2, C403.2, C404.2, J401.2, J402.2, R402.1, R405.1, RV401.3, U401.1 (GND), U402.3 (VSS), U403.3 (VSS)
unnamed: D401.2 (A), R404.1
unnamed: D402.2 (A), R407.1
unnamed: R403.2, U402.2 (OEN)
unnamed: R402.2, U402.6 (ONTIME)
unnamed: R404.2, U402.5 (REL)
unnamed: R406.2, U403.2 (OEN)
unnamed: R405.2, U403.6 (ONTIME)
unnamed: R407.2, U403.5 (REL)
PIR_SENS_POT: R401.1, RV401.1, RV401.2, U402.1 (SENS), U403.1 (SENS)
SIG: D401.1 (K), D402.1 (K), J401.3, J402.3

Notes on the sheet:
2372-709-N-ND
Rotate POT CW for higher sensitivity, CCW for lower sensitivity
2372-713-N-ND

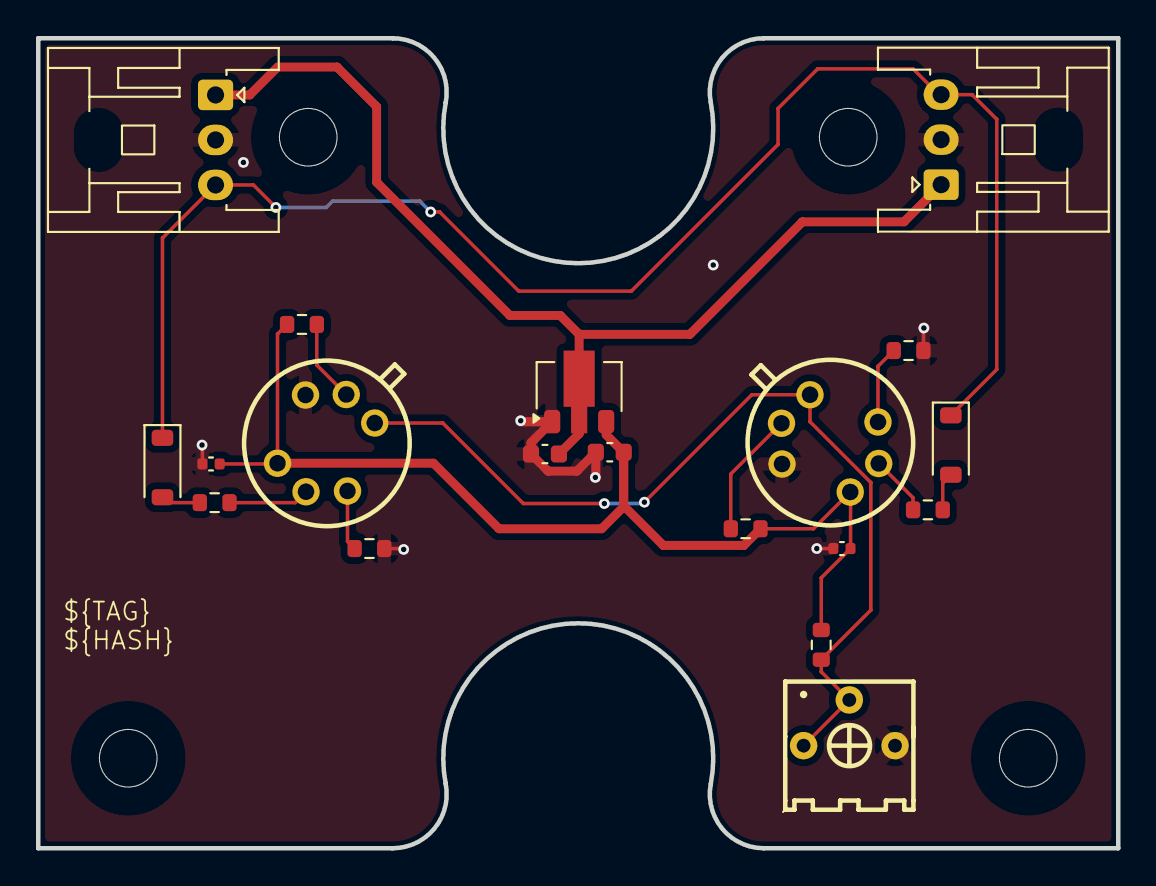
[picture p9: board pir.kicad_pcb from above]

Board: 2 copper layers, 60.0 x 45.0 mm, 23 parts (0 on the bottom side), 13 nets.
