TheCacophonyProject/spool-pcb/cage-hub/cage-hub.kicad_pcb

## KiCad design cage-hub/cage-hub.kicad_pcb (2026-10-27)

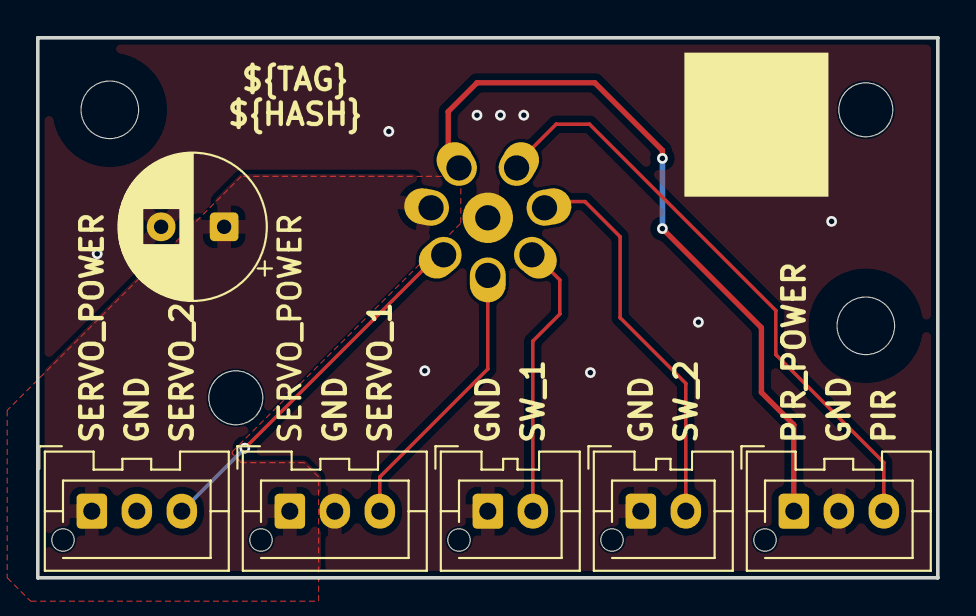
[picture p10: board cage-hub.kicad_pcb from above]

Board: 2 copper layers, 50.0 x 30.0 mm, 12 parts (0 on the bottom side), 8 nets.

Parts:
C501: C_Polarized; CP_Radial_D8.0mm_P3.50mm
H202, H203: KeyHole; 3.0mm_key_hole
H403, H404: MountingHole; MountingHole_3.2mm_M3
J1, J5: Conn_01x02; JST_XA_B02B-XASK-1-A_1x02_P2.50mm_Vertical
J2, J3, J4: Conn_01x03; JST_XA_B03B-XASK-1-A_1x03_P2.50mm_Vertical
J205: JCON_M16_8Pin; jcon-8pin-m16
U1: JLCPCB_QR_8mm

Connections:
GND: C501.2, J1.1, J2.2, J3.2, J4.2, J5.1, J205.1
PIR_POWER: J4.1, J205.8
PIR_SIG: J4.3, J205.2
SERVO_POWER: C501.1, J2.1, J3.1, J205.7
SERVO_SIG_1: J2.3, J205.5
SERVO_SIG_2: J3.3, J205.6
SW_1: J1.2, J205.4
SW_2: J5.2, J205.3
