TheCacophonyProject/spool-pcb/(commit log)

2026-02-09 Add changes for magnet release
    [cutout.FCStd, spool.kicad_pcb, spool.kicad_sch]
2026-02-09 Move files
    [cutout.FCStd, spool.kicad_pcb, spool.kicad_sch]
2026-02-09 Added spool plugs
    [spool-plugs.kicad_pro.kicad_pcb, spool-plugs.kicad_pro.kicad_sch]
2026-02-10 Tidy up
    [spool.kicad_pcb, spool.kicad_sch]
2026-02-10 Add Readme file
    [spool.kicad_sch]
2026-06-03 Added solder helper
    [solder-helper.FCStd]
2026-06-03 Added PIR
    [pir.kicad_sch]
2026-06-20 Add servo, more inputs and update board layout
    [spool.kicad_pcb, spool.kicad_sch]
2026-06-25 Update to use new PIR and added servo outputs
    [spool-plugs.kicad_pcb, spool.kicad_pcb, spool.kicad_sch]
2026-06-26 Added kicad-library as submodule and simplify schematic
    [spool.kicad_pcb, spool.kicad_sch]
2026-06-26 Update kicad-library
2026-06-26 Update library paths
    [spool-plugs.kicad_pcb, spool-plugs.kicad_sch]
2026-06-26 Remove parts from position file
    [spool.kicad_pcb, spool.kicad_sch]
2026-09-01 Update PIR PCB
2026-09-01 Fix pin label
2026-10-27 Update spool with new connector
2026-10-27 Update trap plug PCB
2026-11-05 Fix ground and APIR pinout
